Marcoss53/masaustu-robot-v1/3d_parcalar/6_kafa_arka.stl

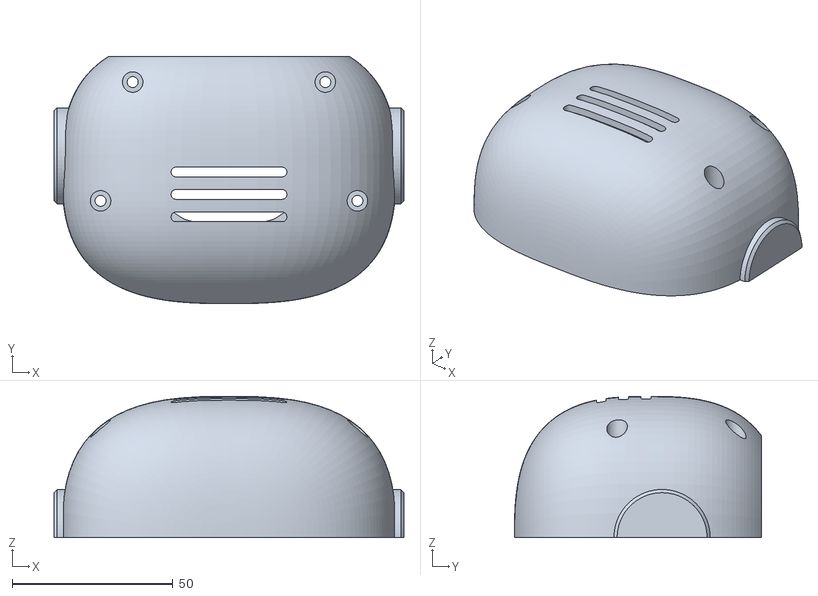
[picture p9: CAD file, 2026-10-11]
3d_parcalar/6_kafa_arka.stl
109.0 x 77.0 x 44.0
