Marcoss53/masaustu-robot-v1/tum_parcalar.3mf

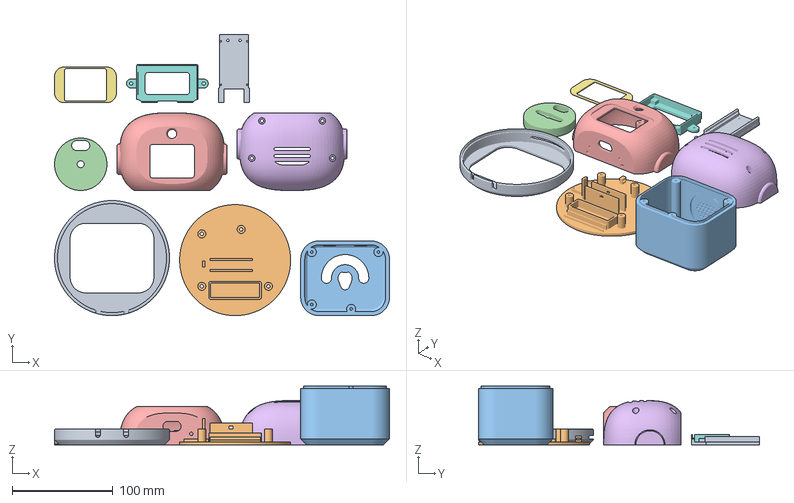
[picture p10: CAD file, 2026-10-11]
tum_parcalar.3mf
332.0 x 278.7 x 58.4 mm
pedestal
base_plate
body_shell
neck_hub
head_front
head_back
visor
display_bracket
camera_bracket
