Marcoss53/masaustu-robot-v1/3d_parcalar/8_kamera_braketi.stl

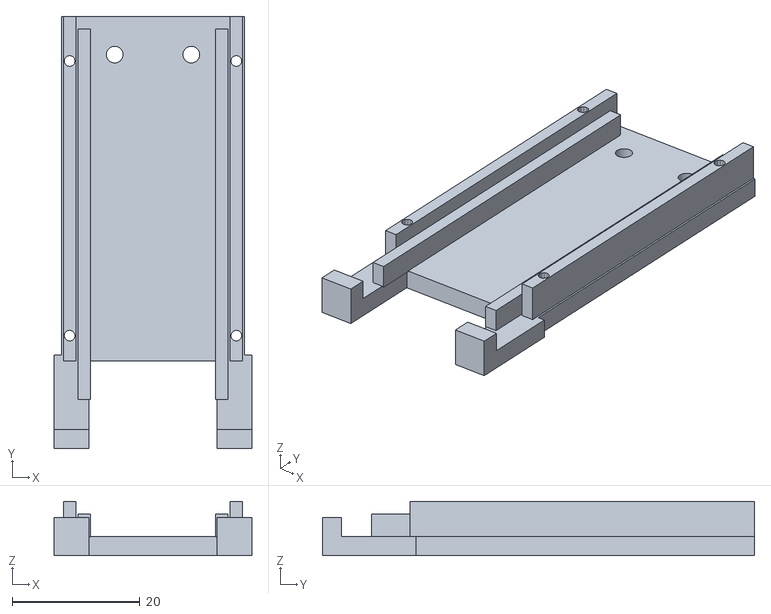
[picture p11: CAD file, 2026-10-11]
3d_parcalar/8_kamera_braketi.stl
31.0 x 67.7 x 8.50
