Marcoss53/masaustu-robot-v1/yeni_3parca_tek_tabla.3mf

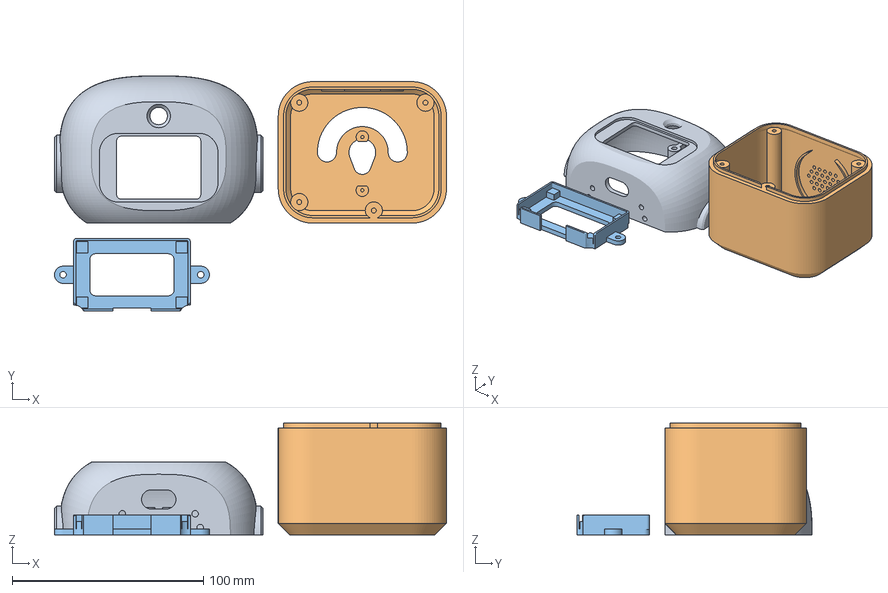
[picture p12: CAD file, 2026-10-11]
yeni_3parca_tek_tabla.3mf
205.0 x 123.0 x 58.4 mm
head_front_v2
body_shell_v2
display_bracket_v2
