Marcoss53/masaustu-robot-v1/3d_parcalar/1_taban_plakasi.stl

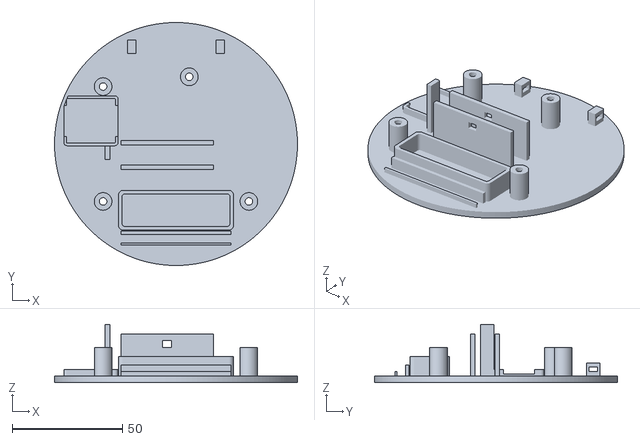
[picture p13: CAD file, 2026-10-11]
3d_parcalar/1_taban_plakasi.stl
110.0 x 110.0 x 26.4
