Marcoss53/masaustu-robot-v1/3d_parcalar/7_ekran_braketi.stl

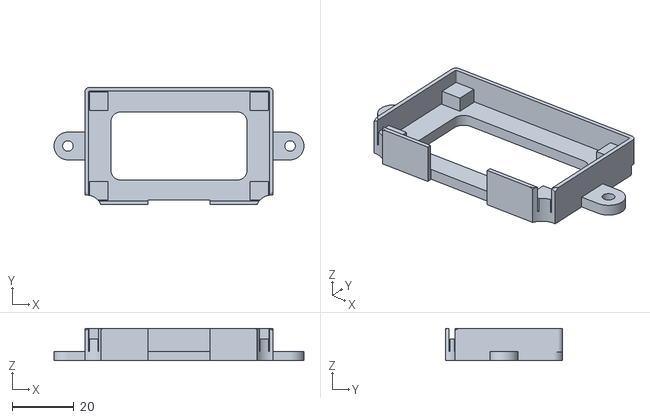
[picture p14: CAD file, 2026-10-11]
3d_parcalar/7_ekran_braketi.stl
81.0 x 38.0 x 10.5
