Marcoss53/masaustu-robot-v1/3d_parcalar/4_boyun.stl

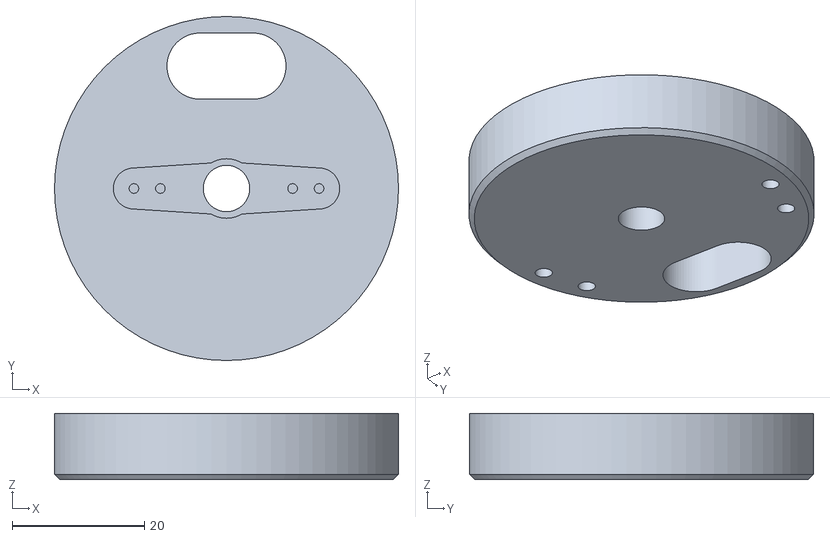
[picture p15: CAD file, 2026-10-11]
3d_parcalar/4_boyun.stl
52.0 x 52.0 x 10.0
