Marcoss53/masaustu-robot-v1/3d_parcalar/3_govde.stl

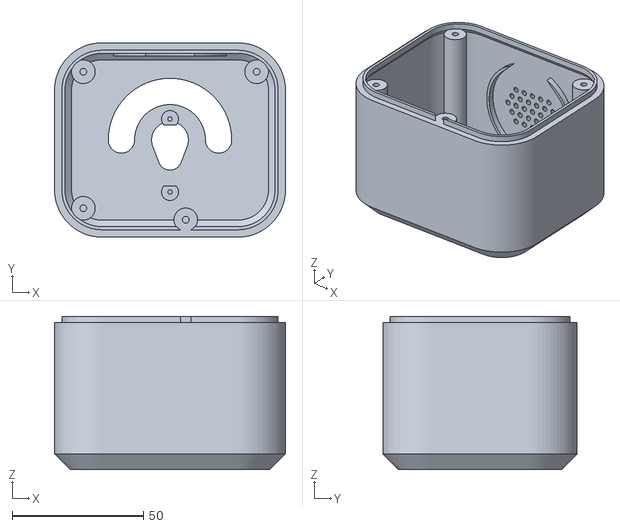
[picture p16: CAD file, 2026-10-11]
3d_parcalar/3_govde.stl
88.0 x 74.0 x 58.4
