Marcoss53/masaustu-robot-v1/3d_parcalar/2_kaide.stl

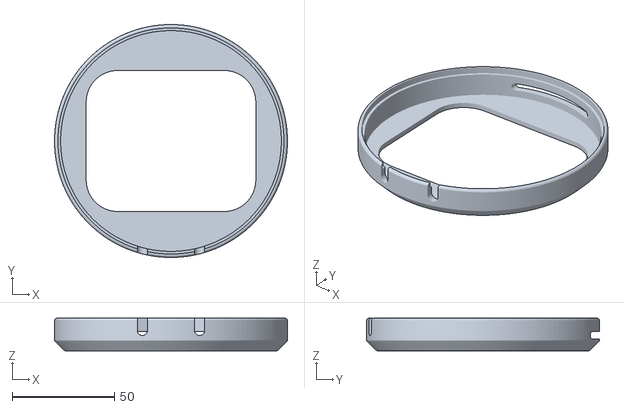
[picture p17: CAD file, 2026-10-11]
3d_parcalar/2_kaide.stl
114.0 x 114.0 x 16.0
