Marcoss53/masaustu-robot-v1/3d_parcalar/9_vizor_siyah.stl

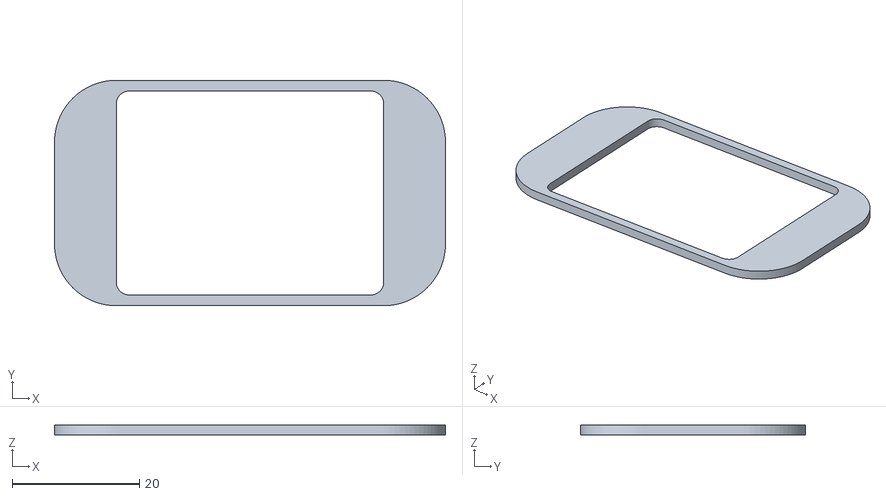
[picture p18: CAD file, 2026-10-11]
3d_parcalar/9_vizor_siyah.stl
61.4 x 35.4 x 1.60
