Marcoss53/masaustu-robot-v1/3d_parcalar/5_kafa_on.stl

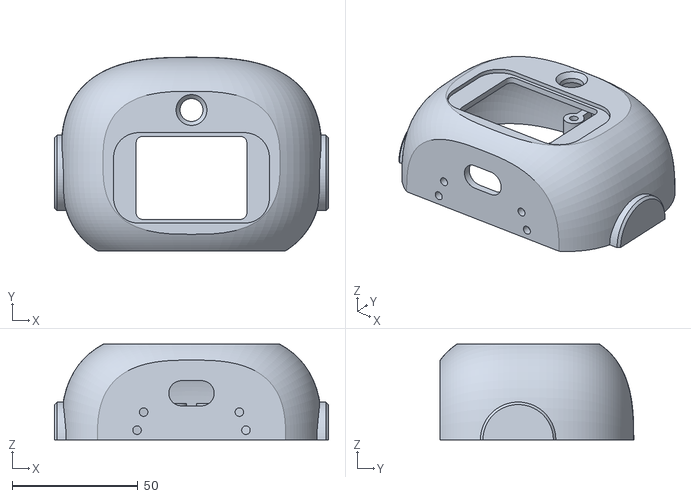
[picture p19: CAD file, 2026-10-11]
3d_parcalar/5_kafa_on.stl
109.0 x 77.0 x 38.0
