Marcoss53/masaustu-robot-v1/(commit log)

2026-10-11 Masaüstü Robot v1: 3D model, STL/3MF, ESP32 firmware, PC uygulaması ve dokümanlar
    [base_plate.stl, body_shell.stl, camera_bracket.stl, desk_robot_v1.3mf, desk_robot_v1.scad, display_bracket.stl, head_back.stl, head_front.stl]
2026-10-11 Dosya adları sadeleştirildi, bağlantı şeması eklendi
    [1_taban_plakasi.stl, 2_kaide.stl, 3_govde.stl, 4_boyun.stl, 5_kafa_on.stl, 6_kafa_arka.stl, 7_ekran_braketi.stl, 8_kamera_braketi.stl]
